yeltsov/simon-course-work/README.md

# Игра на развитие памяти

### В ролях
* Atmel ATmega16
  * UART
  * EEPROM
* Семисегментный индикатор
* Матричная клавиатура

### Скачать
* [Отчет](https://github.com/yeltsov/simon-course-work/raw/master/report/report.docx)
* [Принципиальная схема](https://github.com/yeltsov/simon-course-work/raw/master/report/report_b.docx)
* [Исходный код](https://raw.githubusercontent.com/yeltsov/simon-course-work/master/simon-studio/simon-studio/main.c)

### Пример работы

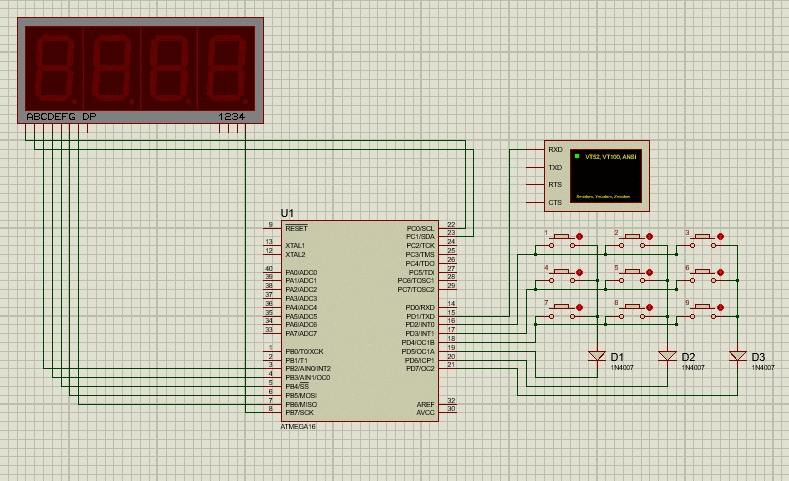
[picture p1: animation.gif]
simon
