yeltsov/simon-course-work/pcb/simon-sch.jpg

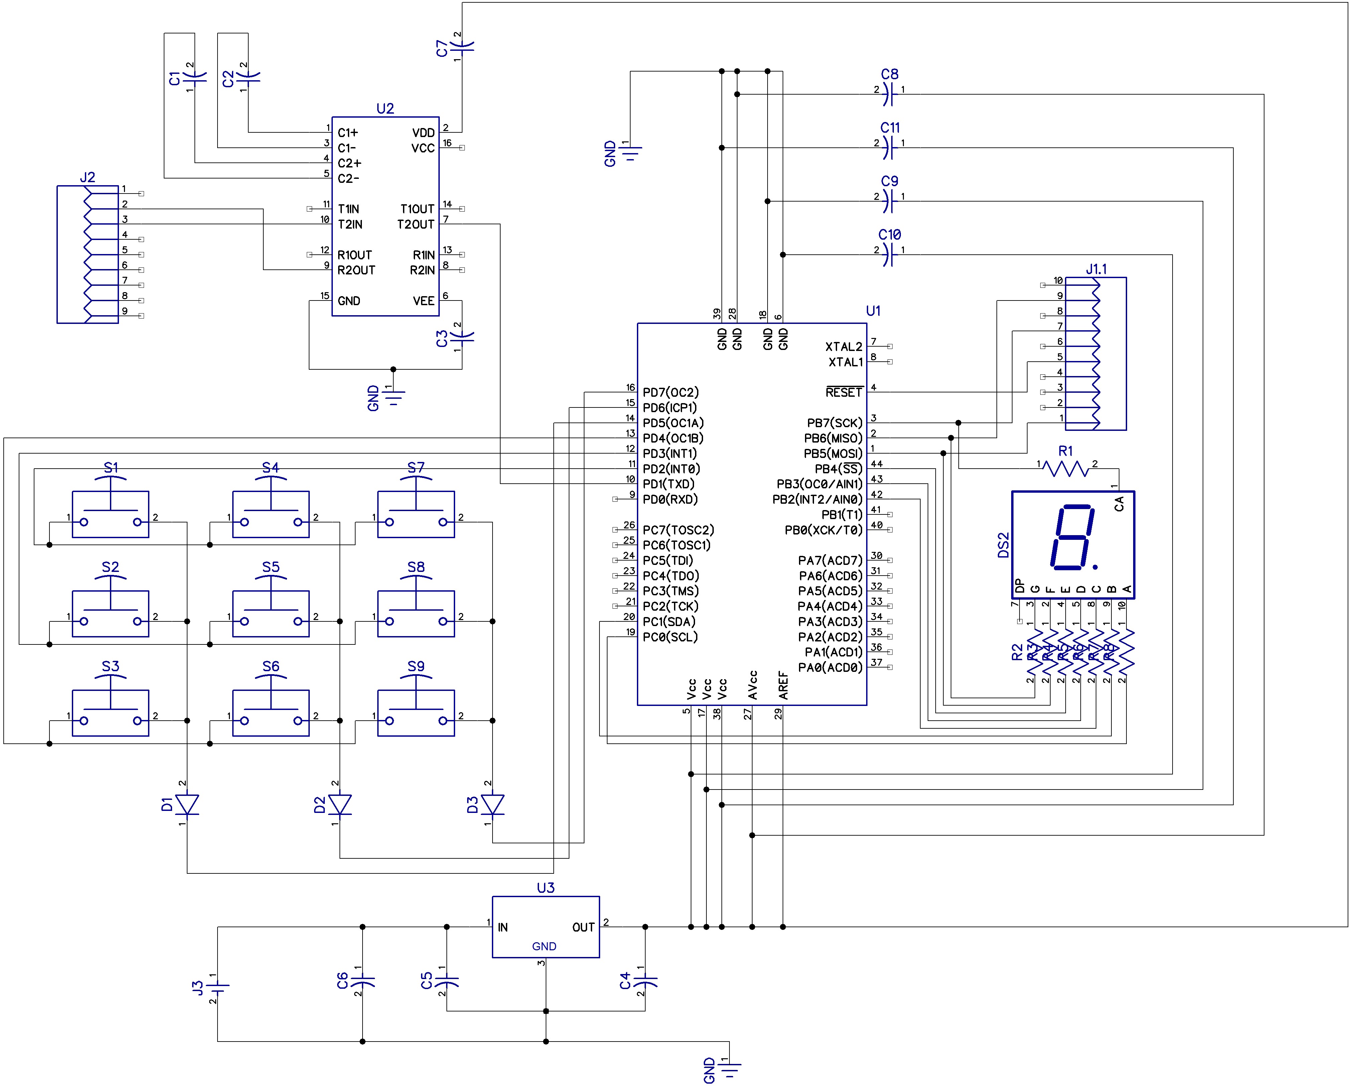
pcb/simon-sch.jpg
