yeltsov/simon-course-work/(list of files, drawings)

Other design files:
pcb/simon.dch
pcb/simon.dip
simon.pdsprj
