yeltsov/simon-course-work/(commit log)

2016-05-11 pcb pushbuttons changes
    [simon.dch, simon.dip]
2016-05-11 resistors fix
    [simon.dch, simon.dip]
2016-05-11 change location
    [simon.dch, simon.dip]
